simonrichards150/ParamotorMultiSensor/Hardware/Paramotor Sensor Main Rev A.pdf

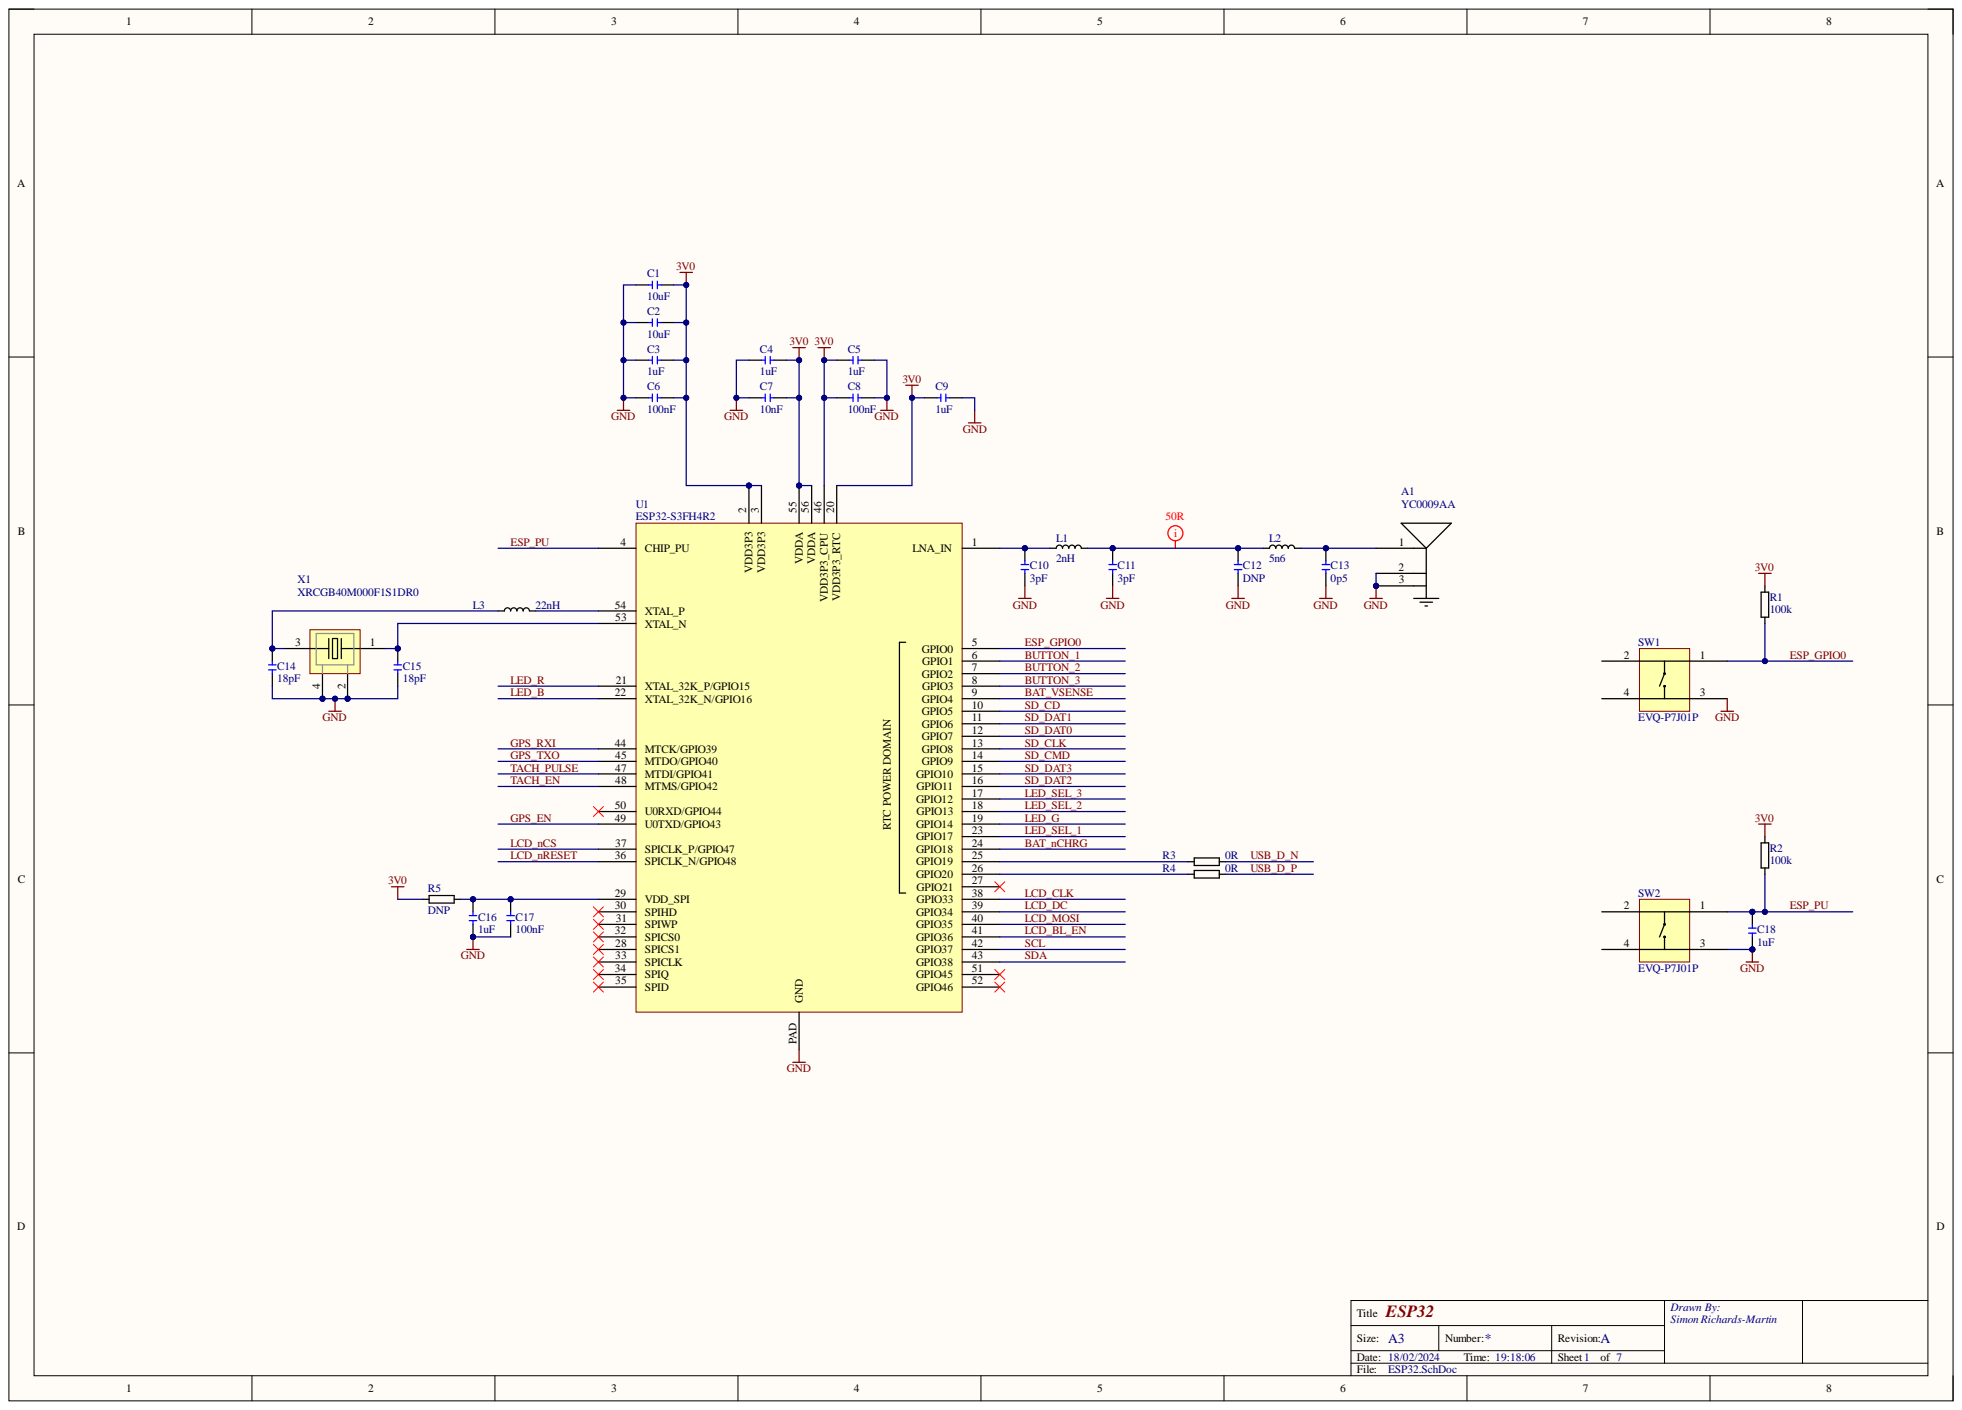
[picture p1: page 1]

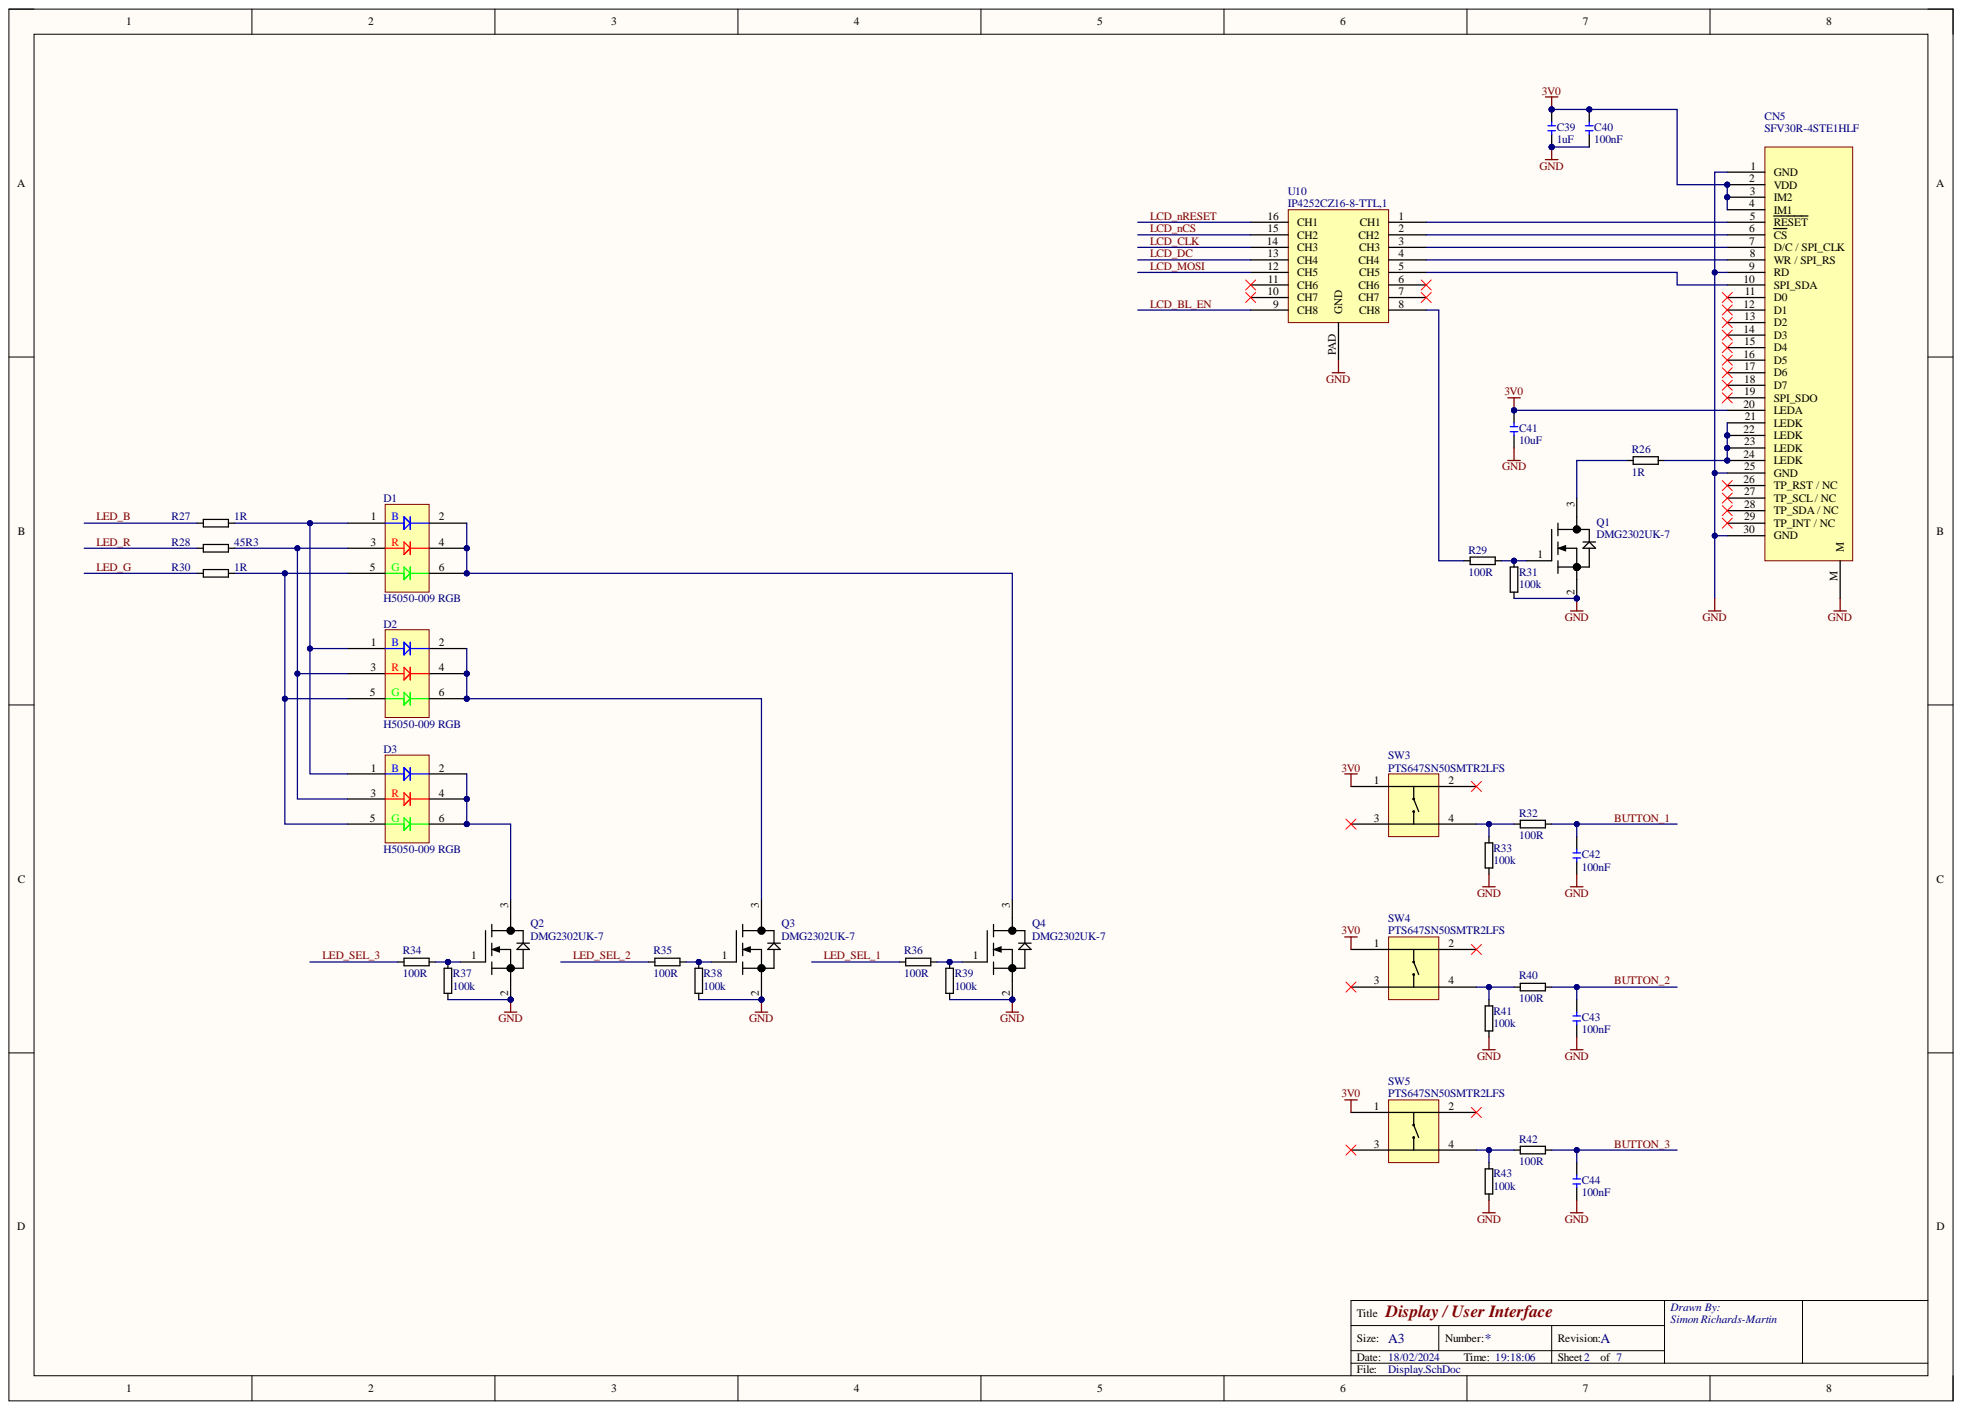
[picture p2: page 2]

LEDK 21
LEDK 22

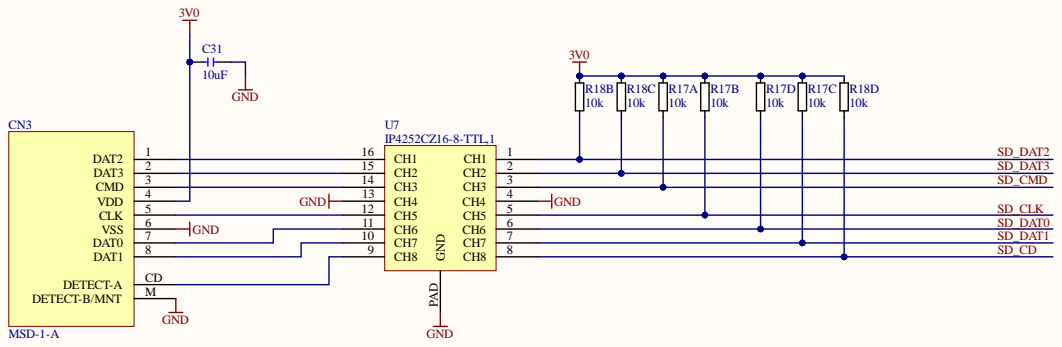
[picture p3: page 3]

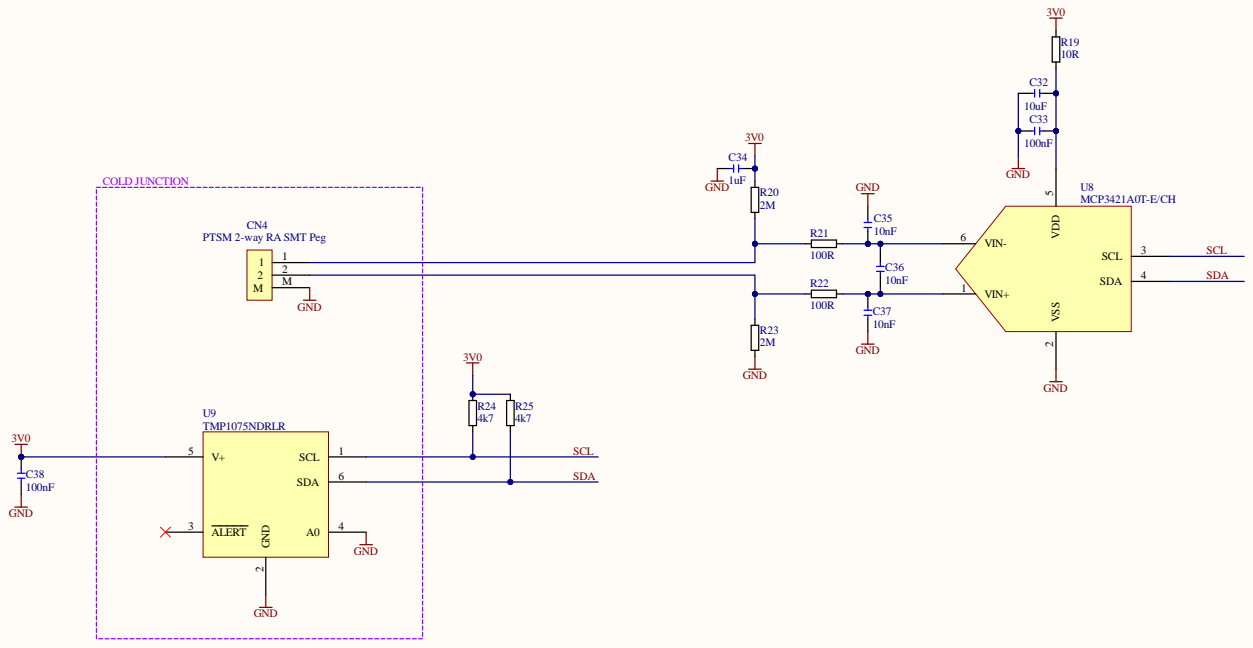
[picture p4: page 4]

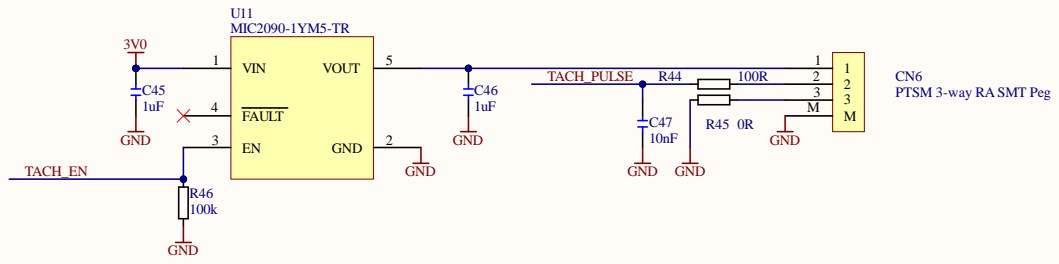
[picture p5: page 5]

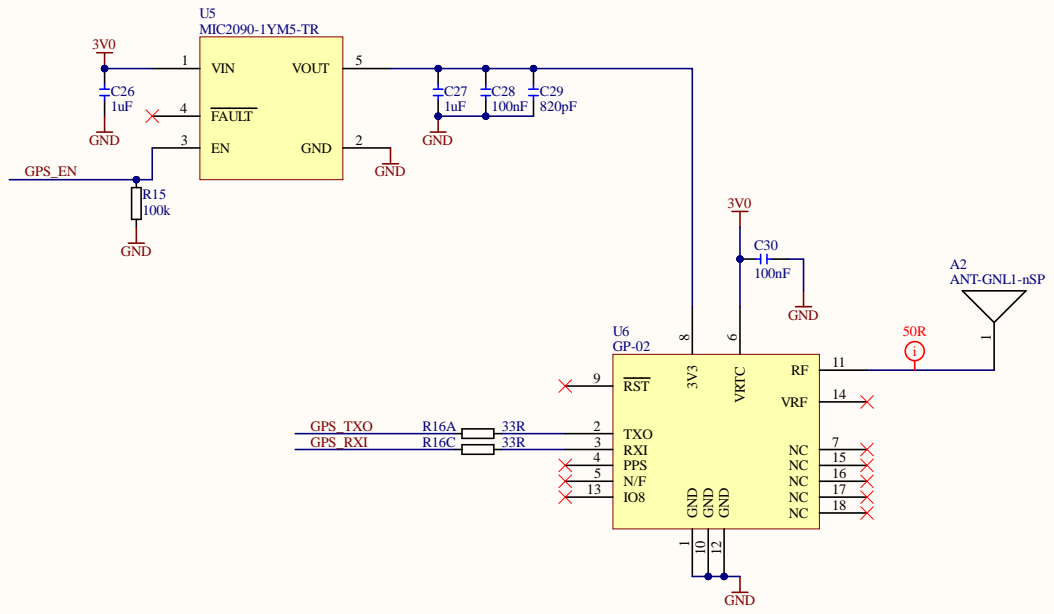
[picture p6: page 6]

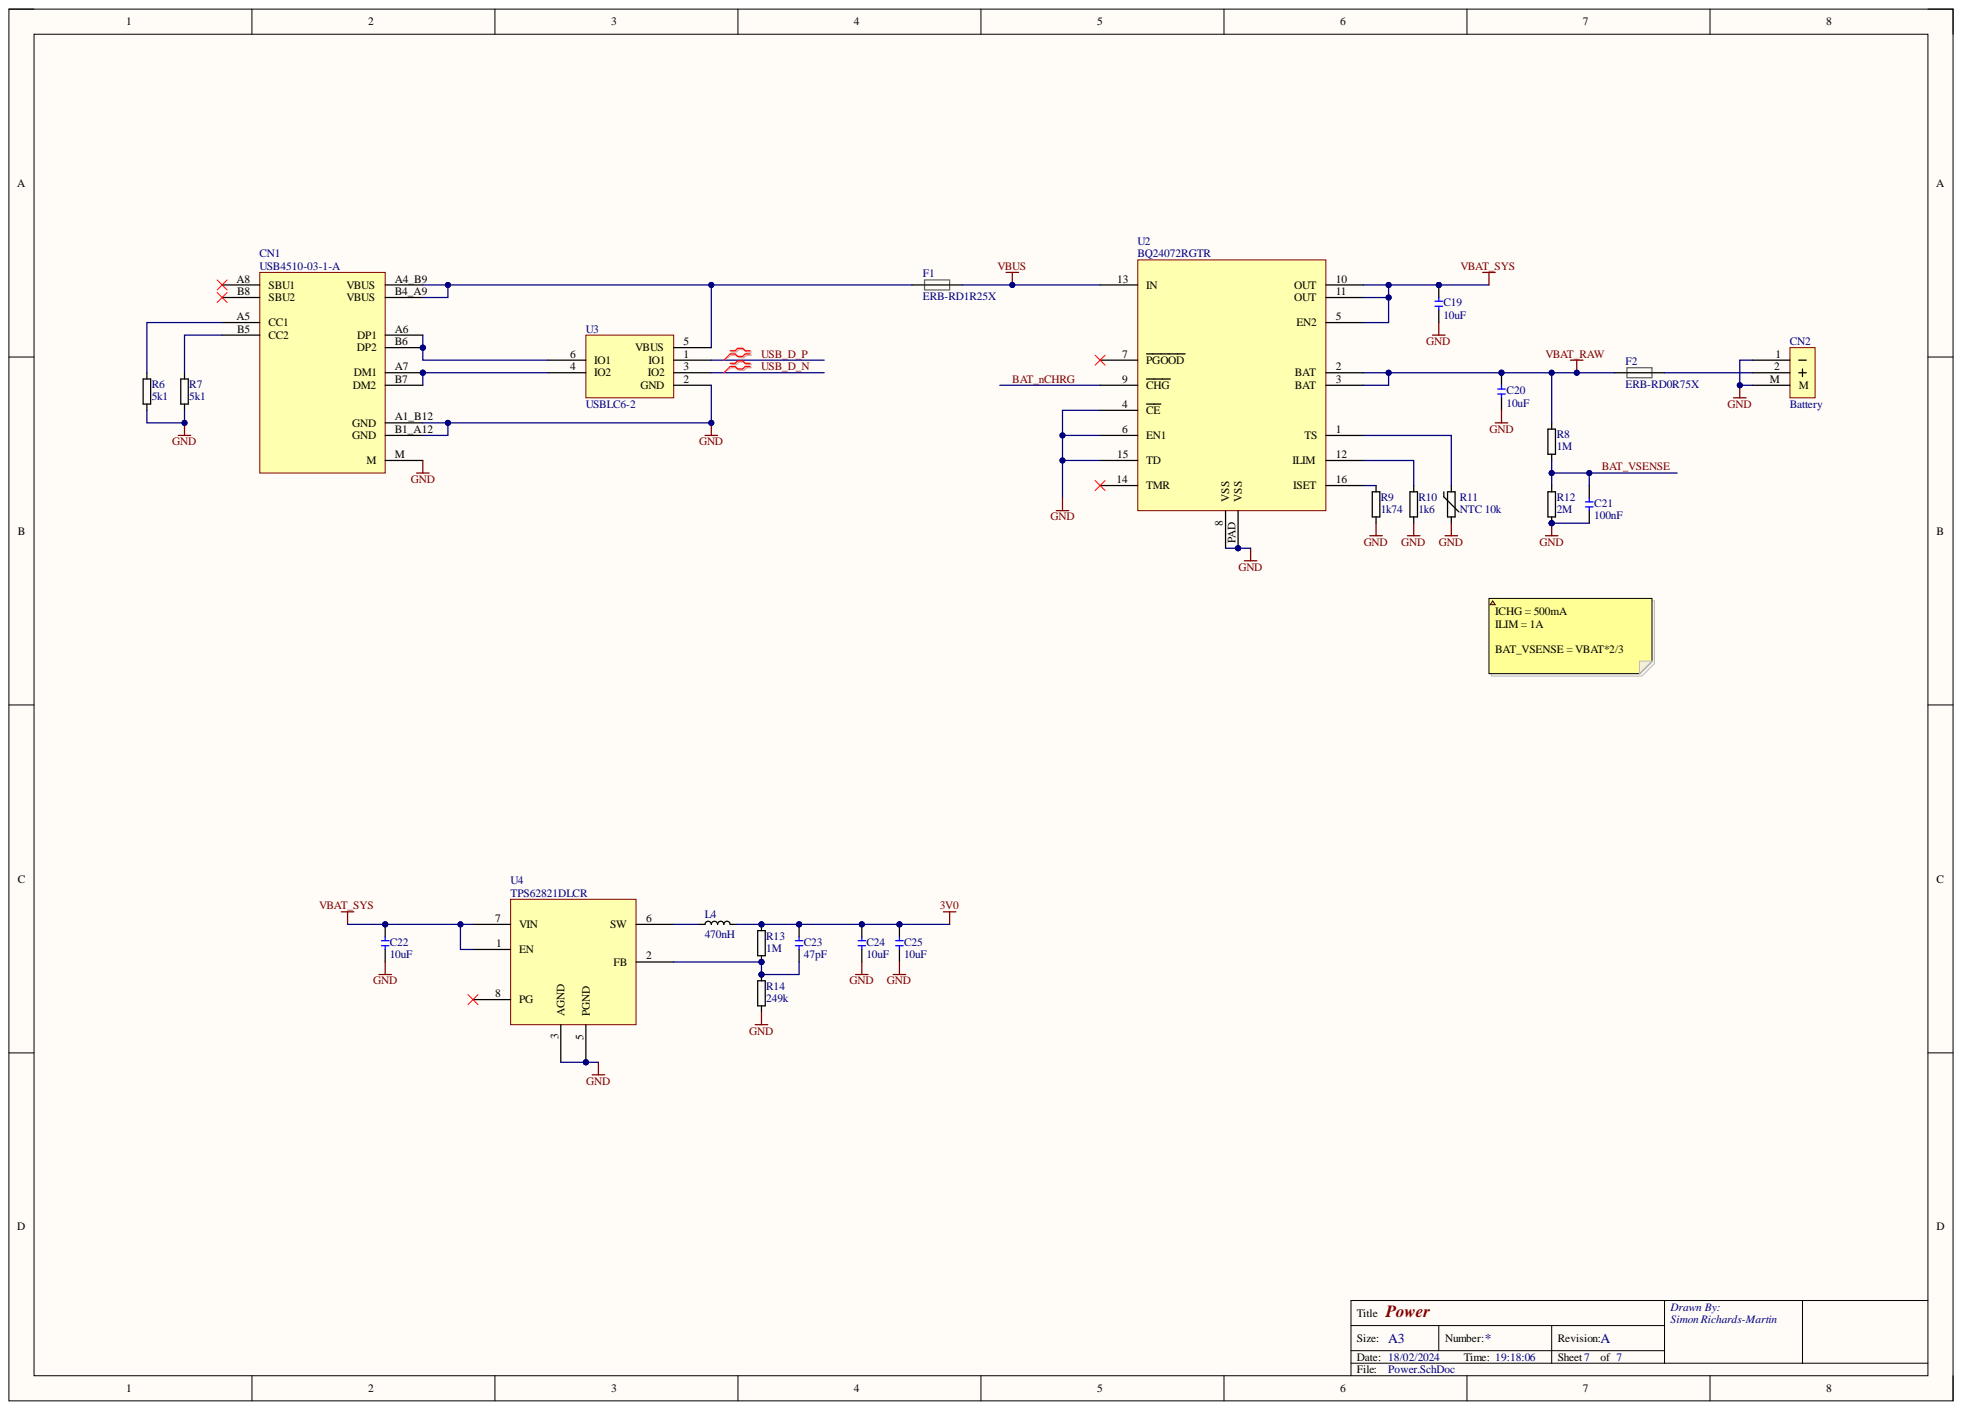
[picture p7: page 7]
