simonrichards150/ParamotorMultiSensor/Hardware/Paramotor Capacitive Sensor.pdf

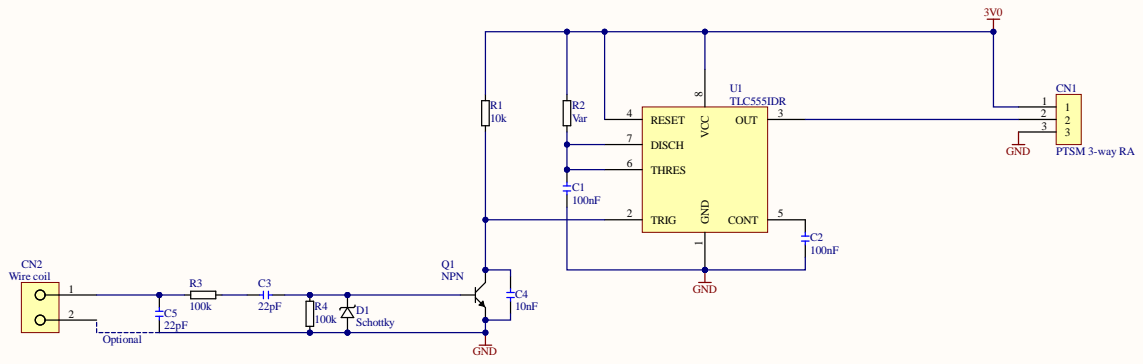
[picture p8: page 1]

R ESE T O UT D ISC H T H R E S | 3 2
