simonrichards150/ParamotorMultiSensor/Hardware/Paramotor Inductive Sensor.pdf

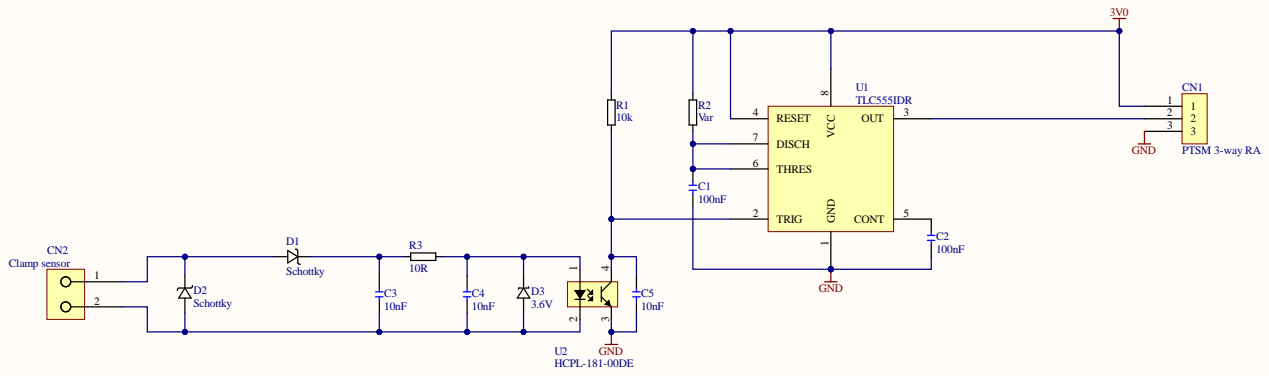
[picture p9: page 1]

R ESE T O UT D ISC H T H R E S | 3 2
