simonrichards150/ParamotorMultiSensor/include/TFT_eSPI_Config/User_Setups/Paramotor_Sensor_TFT.h

#define USER_SETUP_ID 999

#define ST7789_DRIVER

//#define TFT_INVERSION_ON

#define TFT_WIDTH 170
#define TFT_HEIGHT 320

#define TFT_MOSI    35
#define TFT_MISO    45 //Fake pin, no MISO in real life, just to make DMA work
#define TFT_SCLK    33 //
#define TFT_CS      47 //
#define TFT_DC      34 //
#define TFT_RST     48 //
#define TFT_BL 		36 //
#define TFT_BACKLIGHT_ON HIGH

#define LOAD_GLCD   // Font 1. Original Adafruit 8 pixel font needs ~1820 bytes in FLASH
#define LOAD_FONT2  // Font 2. Small 16 pixel high font, needs ~3534 bytes in FLASH, 96 characters
#define LOAD_FONT4  // Font 4. Medium 26 pixel high font, needs ~5848 bytes in FLASH, 96 characters
#define LOAD_FONT6  // Font 6. Large 48 pixel font, needs ~2666 bytes in FLASH, only characters 1234567890:-.apm
#define LOAD_FONT7  // Font 7. 7 segment 48 pixel font, needs ~2438 bytes in FLASH, only characters 1234567890:-.
#define LOAD_FONT8  // Font 8. Large 75 pixel font needs ~3256 bytes in FLASH, only characters 1234567890:-.
#define LOAD_GFXFF  // FreeFonts. Include access to the 48 Adafruit_GFX free fonts FF1 to FF48 and custom fonts

#define SMOOTH_FONT

// #define SPI_FREQUENCY   1000000
// #define SPI_FREQUENCY   5000000
// #define SPI_FREQUENCY  10000000
// #define SPI_FREQUENCY  20000000
// #define SPI_FREQUENCY 27000000 // Actually sets it to 26.67MHz = 80/3
#define SPI_FREQUENCY  40000000 // Maximum to use SPIFFS
// #define SUPPORT_TRANSACTIONS
