simonrichards150/ParamotorMultiSensor/include/Display.h

//Display Handler
//Simon Richards-Martin

#ifndef DISPLAY_H
#define DISPLAY_H
#include <Arduino.h>
#include <time.h>

#include <TFT_eSPI.h>
#define USE_DMA_TO_TFT
#define COLOR_DEPTH 16 //Required for DMA

#include "NotoSansMonoSCB20.h"
#include "NotoSansBold15.h"
//#include "NotoSansBold36.h"
//#include "splashimg.h"

#define DISPLAY_HEIGHT 170
#define DISPLAY_WIDTH 320

#define BUTTON1_Y 24
#define BUTTON2_Y 70
#define BUTTON3_Y 114

#define STATUSBAR_HEIGHT 24
#define STATUSBAR_OFFSET DISPLAY_HEIGHT-STATUSBAR_HEIGHT //146
#define STATUSBAR_BG 0x1804 //0x2008 //0x300c //0x5014 //0x0801 //0x1004 //0x0841

#define GAUGE_DIAMETER 100
#define GAUGE_PADDING 10
#define GAUGE_ARC_THICKNESS 6
#define GAUGE_YPOS 20

#define TEMPERATURE_MIN 10 //500
#define TEMPERATURE_MAX 40 //700
#define TEMPERATURE_BG TFT_BLACK
#define TEMPERATURE_FG 0xfba0 //TFT_ORANGE

#define RPM_MIN 0
#define RPM_MAX 10000
#define RPM_BG TFT_BLACK
#define RPM_FG 0xfe40 //0xc7e0 //0x7fe0 //0x981f //0xfe20 //0x901f //TFT_MAGENTA

#define VBAT_MAX 4100 //Bit lower than real to account for bad quality ADC
#define VBAT_MIN 3100

class DisplayHandler //Begin class definition
{
public:

	DisplayHandler();
	void begin();
	void update(double, int, String, int, int, int, int, bool, int);
	void splash();
	void loadMainView();
	void setBacklight(int);
	void sleep();
	
	
private:
	TFT_eSPI tft;
	TFT_eSprite img = TFT_eSprite(&tft);
	
	void drawBatteryIndicator(int, bool);
	void drawTemperatureGauge(double);
	void drawRPMGauge(int);
	void drawStatusBar(String, int, int, int, int);
	
	int loggingstate = 0;
	
}; //End class definition


//Class methods
DisplayHandler::DisplayHandler() //Constructor
{
	//Can't really do anything here
	
}

void DisplayHandler::begin()
{
	
	tft.init();
	tft.setAttribute(PSRAM_ENABLE, false);
	tft.setRotation(3);
	tft.setTextColor(TFT_WHITE, TFT_BLACK, true);
	img.setAttribute(PSRAM_ENABLE, false);
	img.setColorDepth(16);
	loadMainView();
	
}

void DisplayHandler::update(double temp, int rpm, String fix, int sats, int time, int hdg, int batt, bool chrg, int logStatus)
{
	//Update the log button text
	if (logStatus != loggingstate) //Only update if there's a change
	{
		
		if (logStatus == 1) //If logging, show the stop button text
		{
			tft.setTextColor(TFT_BLACK);
			tft.drawString("Start Log >", DISPLAY_WIDTH-2, BUTTON1_Y);
			tft.setTextColor(TFT_WHITE);
			tft.drawString("Stop Log >", DISPLAY_WIDTH-2, BUTTON1_Y);
			loggingstate = logStatus;
		}
		else //If not logging, show the start button text
		{
			tft.setTextColor(TFT_BLACK);
			tft.drawString("Stop Log >", DISPLAY_WIDTH-2, BUTTON1_Y);
			tft.setTextColor(TFT_WHITE);
			tft.drawString("Start Log >", DISPLAY_WIDTH-2, BUTTON1_Y);
			loggingstate = logStatus;
		}
	}
	
	//Update the gauges
	//Temperature
	drawTemperatureGauge(temp);
	
	//RPM
	drawRPMGauge(rpm);
	
	//Update the battery status indicator
	drawBatteryIndicator(batt, chrg);
	
	//Update the status bar
	drawStatusBar(fix, sats, time, hdg, logStatus);
}

void DisplayHandler::splash()
{
	//tft.setSwapBytes(true);
	//tft.pushImage(0, 0, SPLASHIMG_W, SPLASHIMG_H, splashimg); //Write the splash image to the display buffer
	//tft.setTextDatum(3);
	//tft.loadFont(NotoSansMonoSCB20);
	//tft.drawString("Paramotor", 10, DISPLAY_HEIGHT/2);
}

void DisplayHandler::loadMainView()
{
	//Basically just load the static elements, then call update
	tft.fillScreen(TFT_BLACK);
	tft.setCursor(0, 0);
	
	tft.fillRoundRect(0,STATUSBAR_OFFSET,DISPLAY_WIDTH,STATUSBAR_HEIGHT,0,STATUSBAR_BG);
	
	//Draw button text
	tft.setTextDatum(5); //Middle right
	//img.unloadFont();
	tft.setTextColor(TFT_WHITE);
	tft.setTextFont(2);
	tft.drawString("Power Off >", DISPLAY_WIDTH-2, BUTTON3_Y);
	tft.drawString("LEDs", DISPLAY_WIDTH-14, BUTTON2_Y-8);
	tft.drawString("On/Off", DISPLAY_WIDTH-14, BUTTON2_Y+8);
	tft.drawString(" >", DISPLAY_WIDTH-2, BUTTON2_Y);

	tft.drawString("Start Log >", DISPLAY_WIDTH-2, BUTTON1_Y); //Won't be logging when this is drawn
	
	
	drawBatteryIndicator(4200, false);
	drawTemperatureGauge(0);
	drawRPMGauge(-1);
	
	
}

void DisplayHandler::drawStatusBar(String fix, int sats, int time, int hdg, int logStatus)
{	
	img.createSprite(280,STATUSBAR_HEIGHT); //Status bar 280px wide excluding battery indicator
	img.fillSprite(STATUSBAR_BG);
	img.unloadFont();
	img.loadFont(NotoSansMonoSCB20);
	img.setTextColor(TFT_WHITE);
	img.setTextDatum(3);
	
	//Time start
	if (time > 0)
	{
		//Convert epoch time to time_t
		time_t currentTime = time;
		int hours = gmtime(&currentTime)->tm_hour;
		int mins = gmtime(&currentTime)->tm_min;
		int secs = gmtime(&currentTime)->tm_sec;
		//Prepare string containing time
		char timeNow[6]; 
		sprintf(timeNow, "%02d:%02d", hours, mins);
		img.drawString(timeNow, 6, STATUSBAR_HEIGHT/2);
	}
	else
	{
		img.drawString("--:--", 2, STATUSBAR_HEIGHT/2);
	}
	//Time end
	
	//Log status begin
	if (logStatus == 1)
	{
		img.drawString("LOGGING", 70, STATUSBAR_HEIGHT/2);
	}
	else if (logStatus == 0)
	{
		img.drawString("IDLE", 70, STATUSBAR_HEIGHT/2);
	}
	else if (logStatus < 0)
	{
		img.drawString("LOG ERR", 70, STATUSBAR_HEIGHT/2);
	}
	else if (logStatus == 2)
	{
		img.drawString("NO CARD", 70, STATUSBAR_HEIGHT/2);
	}
	else if (logStatus == 3)
	{
		img.drawString("LOW BAT", 70, STATUSBAR_HEIGHT/2);
	}
	
	
	//Log status end
	
	//GPS status begin
	//Fix and satellites
	if (fix != "3D")
	{
		img.setTextColor(TFT_RED);
		img.drawString("NOFIX", 160, STATUSBAR_HEIGHT/2);
		img.setTextColor(TFT_WHITE);
	}
	else
	{
		char fixNow[7]; 
		sprintf(fixNow, "%s(%02d)", fix, sats);
		img.setTextColor(TFT_GREEN);
		img.drawString(fixNow, 160, STATUSBAR_HEIGHT/2);
		img.setTextColor(TFT_WHITE);
	}
	
	//Heading
	if (hdg < 1)
	{
		img.drawString("---", 236, STATUSBAR_HEIGHT/2);
	}
	else
	{
		char hdgNow[4]; 
		sprintf(hdgNow, "%03d", (int)round(hdg));
		img.drawString(hdgNow, 236, STATUSBAR_HEIGHT/2);
	}
	img.unloadFont();
	img.loadFont(NotoSansBold15);
	img.drawString("o", 270, (STATUSBAR_HEIGHT/2)-6); //Degree symbol
	//GPS status end
	
	//Push to display
	img.pushSprite(0, STATUSBAR_OFFSET+2, TFT_TRANSPARENT);
	img.deleteSprite();

	
}

void DisplayHandler::drawBatteryIndicator(int batt, bool chg)
{
	int pc = 0;
	
	if (batt >= VBAT_MAX) //Full battery
	{
		pc = 100;
	}
	else if (batt <= VBAT_MIN) //Empty battery
	{
		pc = 0;
	}
	else
	{
		pc = ((float)(batt-VBAT_MIN)/(float)(VBAT_MAX-VBAT_MIN)*100.0); //Calculate battery percentage
	}
	
	//Draw battery indicator
	img.createSprite(33,STATUSBAR_HEIGHT-8);
	img.fillSprite(TFT_TRANSPARENT);
	
	img.drawRoundRect(0,0,29,STATUSBAR_HEIGHT-8,1,TFT_WHITE);
	img.fillRoundRect(28,((STATUSBAR_HEIGHT-8)/2)-3,3,6,1,TFT_WHITE);
	
	if (chg) //Charging (battery reading is wrong when charging)
	{
		img.fillRoundRect(2,2,25,STATUSBAR_HEIGHT-12,0,TFT_BLACK);
		img.setTextDatum(4);
		img.setTextColor(TFT_WHITE);
		img.unloadFont();
		img.setTextFont(2);
		img.drawString("CHG", (img.width()/2)-1, img.height()/2);
	}
	else //Not charging
	{
		
		//Fill the variable part of the indicator with background colour
		img.fillRoundRect(2,2,25,STATUSBAR_HEIGHT-12,0,TFT_BLACK);
		
		//Draw battery percentage indicator (colour according to percentage)
		if (pc >= 50) //Above 50% in green
		{
			img.fillRoundRect(2,2,(25.0/100.0)*pc,STATUSBAR_HEIGHT-12,0,TFT_GREEN);
		}
		else if (pc >= 20) //Above 20% in orange
		{
			img.fillRoundRect(2,2,(25.0/100.0)*pc,STATUSBAR_HEIGHT-12,0,TFT_ORANGE);
		}
		else if (pc < 20) //<20% in red
		{
			if (pc < 5)
			{
				pc = 5; //Keep a tiny bit of red even when the percentage should show nothing
			}
			
			img.fillRoundRect(2,2,(25.0/100.0)*pc,STATUSBAR_HEIGHT-12,0,TFT_RED);
		}
	}
	
	
	
	//Push to display
	img.pushSprite(286, STATUSBAR_OFFSET + ((STATUSBAR_HEIGHT-img.height())/2), TFT_TRANSPARENT);
	img.deleteSprite();
	
}

void DisplayHandler::drawTemperatureGauge(double tempC)
{
	//Convert to percent (actually per mille)
	int pc = 0;
	
	
	if (tempC >= TEMPERATURE_MAX) 
	{
		pc = 1000;
	}
	else if (tempC <= TEMPERATURE_MIN) 
	{
		pc = 0;
	}
	else
	{
		pc = (int)(((tempC-TEMPERATURE_MIN)/(TEMPERATURE_MAX-TEMPERATURE_MIN))*1000); 
	}
	

	
	//Prepare sprite
	img.createSprite(GAUGE_DIAMETER+(GAUGE_PADDING*2), GAUGE_DIAMETER+(GAUGE_PADDING*2)+26);
	img.fillSprite(TFT_BLACK);
	img.setTextColor(TFT_WHITE);
	
	img.drawSmoothArc((GAUGE_DIAMETER+(GAUGE_PADDING*2))/2,(GAUGE_DIAMETER+(GAUGE_PADDING*2))/2+20,(GAUGE_DIAMETER/2)+4,(GAUGE_DIAMETER/2)-GAUGE_ARC_THICKNESS-4,40,320,TFT_WHITE,TFT_TRANSPARENT,true);
	
	img.drawSmoothArc((GAUGE_DIAMETER+(GAUGE_PADDING*2))/2,(GAUGE_DIAMETER+(GAUGE_PADDING*2))/2+20,(GAUGE_DIAMETER/2)+2,(GAUGE_DIAMETER/2)-GAUGE_ARC_THICKNESS-2,40,320,TFT_BLACK,TFT_WHITE,true);
	
	int angle = ((280.0/1000.0)*pc)+40;
	
	if (angle >= 41) //Don't display any arc if the percentage is too small
	{
		img.drawSmoothArc((GAUGE_DIAMETER+(GAUGE_PADDING*2))/2,(GAUGE_DIAMETER+(GAUGE_PADDING*2))/2+20,GAUGE_DIAMETER/2,(GAUGE_DIAMETER/2)-GAUGE_ARC_THICKNESS,40,angle,TEMPERATURE_FG,TFT_BLACK,true);
	}
	
	//Prepare the midpoint marker
	int xval = (GAUGE_DIAMETER+(GAUGE_PADDING*2))/2;
	img.drawWideLine(xval,22,xval,26,2,TFT_WHITE);
	img.setTextDatum(7);
	img.unloadFont();
	img.setTextFont(2);
	img.drawNumber(((TEMPERATURE_MAX-TEMPERATURE_MIN)/2)+TEMPERATURE_MIN, (GAUGE_DIAMETER+(GAUGE_PADDING*2))/2, 20);
	
	//Prepare the min/max markers
	//min
	img.drawWideLine(xval-30,122,xval-30,126,2,TFT_WHITE);
	img.setTextDatum(1);
	img.unloadFont();
	img.setTextFont(2);
	img.drawNumber(TEMPERATURE_MIN, xval-30, 128);
	//max
	img.drawWideLine(xval+30,122,xval+30,126,2,TFT_WHITE);
	img.setTextDatum(1);
	img.unloadFont();
	img.setTextFont(2);
	img.drawNumber(TEMPERATURE_MAX, xval+30, 128);
	
	//Prepare the numerical readout
	img.setTextDatum(4);
	//img.setFreeFont(&FreeSansBold9pt7b);
	img.loadFont(NotoSansMonoSCB20);
	

	if ((tempC > -9999) && (tempC < 9999)) //Don't display an invalid value
	{
		//img.drawNumber((int)tempC, (GAUGE_DIAMETER+(GAUGE_PADDING*2))/2, (GAUGE_DIAMETER+(GAUGE_PADDING*2))/2+15);
		img.drawFloat((float)tempC, 1, (GAUGE_DIAMETER+(GAUGE_PADDING*2))/2, (GAUGE_DIAMETER+(GAUGE_PADDING*2))/2+15);
	}
	else
	{
		img.drawString("ERROR", (GAUGE_DIAMETER+(GAUGE_PADDING*2))/2, (GAUGE_DIAMETER+(GAUGE_PADDING*2))/2+15);
	}
	
	
	img.drawString("C", (GAUGE_DIAMETER+(GAUGE_PADDING*2))/2+5, (GAUGE_DIAMETER+(GAUGE_PADDING*2))/2+35);
	img.unloadFont();
	img.loadFont(NotoSansBold15);
	img.drawString("o", (GAUGE_DIAMETER+(GAUGE_PADDING*2))/2-5, (GAUGE_DIAMETER+(GAUGE_PADDING*2))/2+30); //Degree Symbol made from superscript o
	
	
	//Push to display
	img.pushSprite(0,GAUGE_YPOS-20,TFT_TRANSPARENT);
	img.deleteSprite();
	
}

void DisplayHandler::drawRPMGauge(int rawRPM)
{	
	//Convert to percent (actually per mille)
	int pc = 0;
	
	if (rawRPM >= RPM_MAX) 
	{
		pc = 1000;
	}
	else if (rawRPM <= RPM_MIN) 
	{
		pc = 0;
	}
	else
	{
		pc = (int)((((double)rawRPM-RPM_MIN)/(RPM_MAX-RPM_MIN))*1000); 
	}
	
	//Prepare sprite
	img.createSprite(GAUGE_DIAMETER+(GAUGE_PADDING*2), GAUGE_DIAMETER+(GAUGE_PADDING*2)+26);
	img.fillSprite(TFT_BLACK);
	img.setTextColor(TFT_WHITE);
	
	img.drawSmoothArc((GAUGE_DIAMETER+(GAUGE_PADDING*2))/2,(GAUGE_DIAMETER+(GAUGE_PADDING*2))/2+20,(GAUGE_DIAMETER/2)+4,(GAUGE_DIAMETER/2)-GAUGE_ARC_THICKNESS-4,40,320,TFT_WHITE,TFT_TRANSPARENT,true);
	
	img.drawSmoothArc((GAUGE_DIAMETER+(GAUGE_PADDING*2))/2,(GAUGE_DIAMETER+(GAUGE_PADDING*2))/2+20,(GAUGE_DIAMETER/2)+2,(GAUGE_DIAMETER/2)-GAUGE_ARC_THICKNESS-2,40,320,TFT_BLACK,TFT_WHITE,true);
	
	int angle = ((280.0/1000.0)*pc)+40;
	
	if (angle >= 41) //Don't display any arc if the percentage is too small
	{
		img.drawSmoothArc((GAUGE_DIAMETER+(GAUGE_PADDING*2))/2,(GAUGE_DIAMETER+(GAUGE_PADDING*2))/2+20,GAUGE_DIAMETER/2,(GAUGE_DIAMETER/2)-GAUGE_ARC_THICKNESS,40,angle,RPM_FG,TFT_BLACK,true);
	}
	
	//Prepare the midpoint marker
	int xval = (GAUGE_DIAMETER+(GAUGE_PADDING*2))/2;
	img.drawWideLine(xval,22,xval,26,2,TFT_WHITE);
	img.setTextDatum(7);
	img.unloadFont();
	img.setTextFont(2);
	img.drawNumber(((RPM_MAX-RPM_MIN)/2)+RPM_MIN, (GAUGE_DIAMETER+(GAUGE_PADDING*2))/2, 20);
	
	//Prepare the min/max markers
	//min
	img.drawWideLine(xval-30,122,xval-30,126,2,TFT_WHITE);
	img.setTextDatum(1);
	img.unloadFont();
	img.setTextFont(2);
	img.drawNumber(RPM_MIN, xval-30, 128);
	//max
	img.drawWideLine(xval+30,122,xval+30,126,2,TFT_WHITE);
	img.setTextDatum(1);
	img.unloadFont();
	img.setTextFont(2);
	img.drawNumber(RPM_MAX, xval+30, 128);
	
	//Prepare the numerical readout
	img.setTextDatum(4);
	//img.setFreeFont(&FreeSansBold9pt7b);
	img.loadFont(NotoSansMonoSCB20);
	
	if ((rawRPM > 0) && (rawRPM < 99999))
	{
		img.drawNumber(rawRPM, (GAUGE_DIAMETER+(GAUGE_PADDING*2))/2, (GAUGE_DIAMETER+(GAUGE_PADDING*2))/2+15);
	}
	else
	{
		img.drawString("-", (GAUGE_DIAMETER+(GAUGE_PADDING*2))/2, (GAUGE_DIAMETER+(GAUGE_PADDING*2))/2+15);
	}
	
	img.drawString("RPM", (GAUGE_DIAMETER+(GAUGE_PADDING*2))/2, (GAUGE_DIAMETER+(GAUGE_PADDING*2))/2+35);
	
	//Push to display
	img.pushSprite((GAUGE_DIAMETER+(GAUGE_PADDING*2)),GAUGE_YPOS-20,TFT_TRANSPARENT);
	img.deleteSprite();
}

void DisplayHandler::setBacklight(int pc)
{
	if ((pc <= 100) && (pc >= 0))
	{
		analogWrite(LCD_BL, pc * 2.55);
	}
	else
	{
		return;
	}
}

void DisplayHandler::sleep()
{
	digitalWrite(LCD_BL, LOW); //Turn off the backlight
	tft.writecommand(0x10); //Try to turn off LCD controller (seems to be ignored)
}



#endif
