simonrichards150/ParamotorMultiSensor/include/splashimg.h

#define SPLASHIMG_H 170
#define SPLASHIMG_W 320

// array size is 108800
static const unsigned short splashimg[] PROGMEM  = {
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
};
