simonrichards150/ParamotorMultiSensor/(commit log)

2024-03-12 Fix NMEA parser buffer overrun
    Fix issue #1
    Implement NMEA sentence validation
    [GPS.h, ParamotorMultiSensor.ino]
2024-03-16 Fix buffer overrun in NMEA parser
    [Display.h, GPS.h, ParamotorMultiSensor.ino, splashimg.h, splashimgb.h]
2024-03-16 Fix incorrect pin assignments
    [Init.h]
2024-03-18 Fix null value being passed to printf
    [GPS.h]
2024-03-19 Fix pin configuration for SD detect
    [Init.h]
2024-03-24 Implement battery status indicator
2024-03-29 Fix formatting of lat/lon in log file
    Negate the values if necessary - for compatibility with log converter tools e.g. gpsvisualizer.com
    [MicroSD.h]
2024-03-29 Add log toggle function and more error handling
    [MicroSD.h, ParamotorMultiSensor.ino]
2024-03-30 Add LED handler
2024-03-30 Revert "Add LED handler"
    This reverts commit 6e8389525746252703de77e6b4dc21f0c7381ea8.
    [Display.h, LEDs.h, ParamotorMultiSensor.ino]
2024-03-30 Revert "Revert "Add LED handler""
    This reverts commit 2b05765c186269b562f42ada1e90f406e0a11299.
    [Display.h, LEDs.h, ParamotorMultiSensor.ino]
2024-03-30 Add led state to SD log data
2024-03-31 Add hysteresis to LED handler
2024-03-31 Add filtering to tachometer
    Fixes #3
    [Display.h, GPS.h, LEDs.h, MicroSD.h, ParamotorMultiSensor.ino, Power.h, Tach.h, Temperature.h]
2024-04-02 Parameterise min/max for battery indicator
2024-04-06 Bug fixes
    Fix #9
    Fix #10
    [MicroSD.h, Tach.h]
